glynhudson/emonTX-SMT/Datasheets/IC's/WiznetW5200820io-Pin.jpg

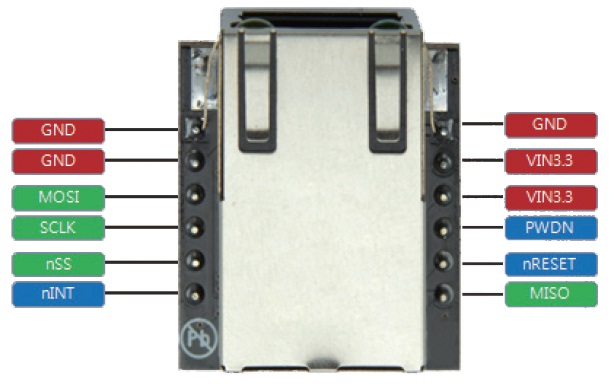
Datasheets/IC's/WiznetW5200820io-Pin.jpg
