glynhudson/emonTX-SMT/README.md

emonTX-SMT
==========

Very early prototype 

openenergymonitor.org

http://openenergymonitor.blogspot.co.uk/search/label/emonTxSMT
http://openenergymonitor.org/emon/node/736
