glynhudson/emonTX-SMT/Datasheets/Atmel AppNote/AppNote Schematic.png

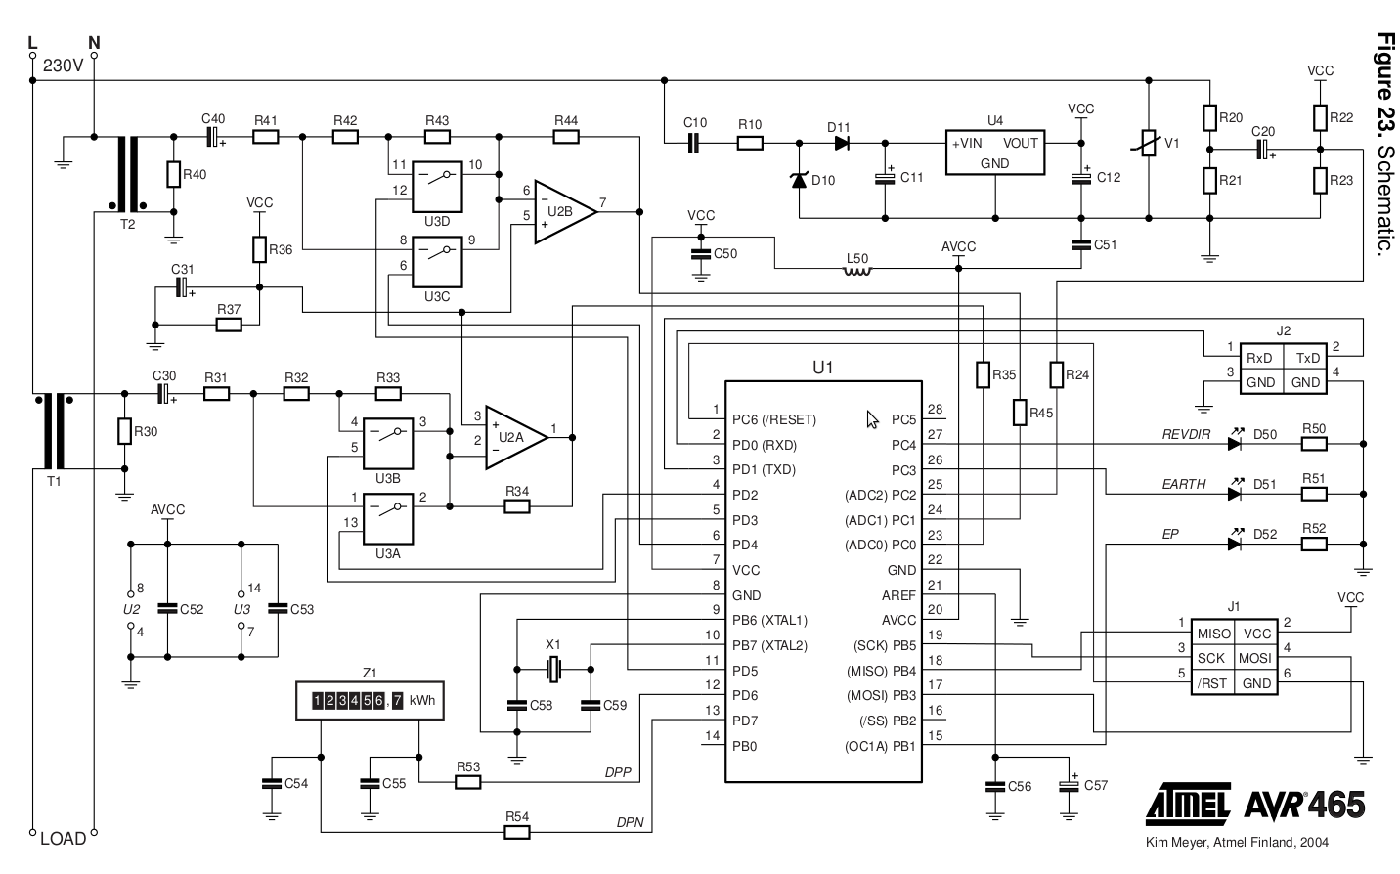
Datasheets/Atmel AppNote/AppNote Schematic.png
