glynhudson/emonTX-SMT/emonTx SMT BOM.ods

Sheet: emonTx SMT BOM
Quantity | Component V0.6 Rev2 | Description | Value | Package | Manufacturer | Manufacturer part No. | RoS | Farnel Code | Farnel Price 100 off | Farnell 100 off board price | RS Code | Rapid Code | Cheapest | Exact Value critical | Country of Origin | Notes
Passives
3 |  | Resistor – CT Burden | 18R 0.25W 1% | 1206 |  |  | YES | 1100145 | £0.01 | £0.04 | 223-2029 | 72-2224 | Rapid
1 |  | Resistor – one-wire temperature | 4.7K | 1206 |  |  | YES | 1470013 (http://uk.farnell.com/vishay-draloric/crcw12064k70fkea/resistor-1206-4k70-1/dp/1470013) | £0.02 | £0.02
4 |  | Resistor – indicator LED's current limiting resistor
1 | R39 | Resistor – AC-DC current limiting | 56R 0.75W 1% (must be 0.62W min) | 2010 | Multicomp | MCPWR10FTEQ0560 | YES | 1887586 (http://uk.farnell.com/multicomp/mcpwr10fteq0560/resistor-2010-56r-1-0-75w/dp/1887586) | £0.08 | £0.08 | nope |  |  | YES! | Taiwan
2 |  | Capacitor – Ceramic - crystal de-coupling | 22pF | 0630 |  |  | YES | 1759057 | £0.01 | £0.01 | 616-9133 | 71-1792
8 |  | Capacitor – de-coupling | 0.1uF | 0603 |  |  | YES | 1759066 | £0.01 | £0.05 | 723-5521 | 71-1854
1 |  | Capacitor – ceramic – v reg output, AC sample – DC supply de-coupling | 1uf 25V | 0603 |  |  | YES | 1759039 | £0.01 | £0.01 | 723-5587 | N/A
2 |  | Capacitor | 10uF 16V | B (4mm) |  |  | YES | 9696920 | £0.08 | £0.17 | 737-9625 | 131794
5 | (C1, C18), C13, C15, C20 | Capacitor – AC to DC rectifier smoothing & CT input de-coupling | 47uF 25V | D (6.3mm) |  |  | YES | 1870614 (http://uk.farnell.com/multicomp/mcesl25v476m6-3x5-4/capacitor-47uf-25v-6-3mm-x-5-4mm/dp/1870614) | £0.11 | £0.55 |  |  |  | only C1 and C18 need to be 25V | China
3 |  | Inductor | 3A 30ohm | 0603 |  |  |  | 1308763 | £0.13 | £0.40
 |  |  |  |  |  |  | YES |  |  | £0.00
Discrete's |  |  |  |  |  |  |  |  |  | #VALUE!
1 | D2 | Reverse blocking power supply diode – Schottky | B052 (62mW Av min) | SOD-123 | Taiwan Semiconductor | B0520LW | YES | 1863141 (http://uk.farnell.com/taiwan-semiconductor/b0520lw/diode-rectif-20v-0-5a-sod123/dp/1863141) | £0.05 | £0.05 | 743-5894 (http://uk.rs-online.com/web/p/rectifier/7435894/) |  | About the same, 50 MOQ RS | No
1 | D1 | Rectifier Diode – AC-DC supply | 1N4148 30V 150mA Av min | SOD-323 |  |  | YES | 1612348 | £0.05 | £0.05 |  |  |  |  | China
1 | U$11 | 12V zener diode – MCp1702 protection from AC over voltage | 12V Zener | SOD-323 |  |  | YES | 1466027 (http://uk.farnell.com/multicomp/bzt52c12s/diode-zener-0-2w-sod-323/dp/1466027) | £0.08 | £0.08 |  |  |  |  | India
1 |  | SMT LED's |  | 0603 |  |  |  |  | £0.08 | £0.08 |  | 56-3102 (http://www.rapidonline.com/Electronic-Components/0603-1-8v-Red-LED-Surface-Mount-40mcd-56-3102)
1 | L1 | AREF filter FERRITE BEAD | 30 ohm 3A | 0603 |  |  |  | 1308763 | £0.11 | £0.11
1 |  | 16Mhz Crystal | 16Mhz | HC49/US |  |  | YES | 1469641 | £0.21 | £0.21 | 703-7129P | 90-1932 | Farnell |  | Mexico
 |  |  |  |  |  |  |  |  |  | £0.00
IC's |  |  |  |  |  |  |  |  |  | #VALUE!
1 |  | 3.3V LOD voltage regulator | MCP1702 3.3V | SOT-89 | Microchip | MCP1702T-3302E/MB | YES | 1605558 | £0.25 | £0.25 | 669-4872 (http://uk.rs-online.com/web/p/low-dropout-voltage-regulators/6694872/) |  | RS | Yes | US
1 |  | 433/868/912Mhz RF transceiver | RFM12B |  | HopeRF/RF Solutions |  |  |  |  | £0.00
1 |  | 8-bit micro controller | Atmega32u4 | TQFP44 | ATMEL | ATMEGA32U4-AU | YES | 1748525MPKG | £3.63 | £3.63 |  |  | RS |  | US
1 |  | Low power Quad Op Amp | LMV324 | SOIC14 | Texas Instruments / STMICROELECTRONICS | LMV324ID | YES | 1102986 | £0.37 | £0.37 | 517-1517 |  | RS
2 |  | Quad Bilateral Analogue Switch | 4066 | SOIC14 | NXP | 4HC4066D | YES | 1201330 | £0.36 | £0.72 | 169-7790 |  | RS – a lot less!
port |  |  |  |  |  |  |  |  |  | #VALUE!
Connectors |  |  |  |  |  |  |  |  |  | #VALUE!
1 |  | USB MicroB |  | SMT | Molex | 47346-0001 | YES | 1568026 | £0.40 | £0.40 | 702-5475P |  | Farnel | YES! | China | Must not have any thru-hole, SMT pads only
3 |  | 3.5mm jack through-hole | Stereo 3.5mm jack | Thru-hole | TruConnect |  | YES |  | £0.17 | £0.52 | 20-0157 |  | Rapid
1 |  | Terminal block 12 – pluggable |  |  | RIA Connect |  |  |  | £2.46 | £2.46 | 493-2563 | 21-4224 (http://www.rapidonline.com/Cables-Connectors/12-Pole-2-5mm-Pitch-Springcon-Lever-Female-Plug-21-4224) | RAPID
1 |  | Terminal block 12 male thu hole right angle |  |  | RIA connect |  |  |  | £0.71 | £0.71 |  | 21-4240 (http://www.rapidonline.com/Cables-Connectors/12-Pole-2-5mm-Pitch-PCB-Mount-Right-Angle-Male-Socket-21-4240) | RAPID
1 |  | 2.1mm Barrel Jack – AC voltage | 2.1mm SMT | SMT | Cliff | FC68148S |  | 1889309 |  | £0.00 |  | 20-0896 | Farnell
1 |  | SMA Ant PCB 90 degrees |  | Tru-hole | TruConnect | 19-49-1-TGG | YES | 2079861 | £0.74 | £1.70 | 512-0070 | 16-1562 | Rapid – by far
2 |  | Xbee Headers | 10pin, 1 row, 2mm pitch | Thru-hole |  |  | YES | 1109732 |  | £0.00 | 605-8796 |  | RS
 |  |  |  |  |  |  |  |  |  | £0.00
 |  |  |  |  |  |  |  |  |  | £0.00
Misc |  |  |  |  |  |  |  |  |  | #VALUE!
1 |  | 3x AAA PCB battery holder | 4.5V | PCB mount | TruPower | BH-331P | YES | 1339843 |  | £0.25 | 481-4077 | 18-2967 | Rapid – by far
1 |  | 433Mhz Ant straight | 433Mhz | SMA | RF-solutions |  | YES | 1304036 |  | £4.91 | 542-535 |  | RS |  |  | 90 degree is actually cheaper on RS
1 |  | 434Mhz Ant 90 degrees | 434Mhz | SMA | RF-solutions |  | YES |  |  | £3.25 | 542-488 |  | RS
1 |  | 868Mhz Ant straight | 868Mhz | SMA | RF-solutions |  | YES | 1304037 |  | £4.91 | 542-551 |  | Rs
1 |  | 868Mhz Ant 90 degrees | 869Mhz | SMA | RF-solutions |  | YES | 1717225RL (http://uk.farnell.com/bourns/mf-fsmf020x-2/multifuse-smd-0603-0-2a/dp/1717225RL) |  | £2.14 | 542-563 |  | RS
1 |  | USB PTC Fuse | 200mA holding 500mA trip? | ??? |  |  | YES |  |  | £0.00
1 | R23 | AC-DC PTC Fuse | 40mA holding 150mA trip | 1210 |  |  |  | 1861176 (http://uk.farnell.com/multicomp/mc36203/resettable-fuse-smd-0-05a/dp/1861176) | £0.09 | £0.09 |  |  |  |  | Taiwan

Sheet: Op-amp Test
1 | C31 | Bias stabilising cap | 10 uF | 3201454
5 | C20, C30, C40 | DC decoupling caps on input stage | 47 uF | 3201478
1 | R20, | Top AC adapter step down (best precision?) | 10 k
4 | R21, R24, R35, R45 | Bottom step down (best precision?) and current limiting resistors | 1 kΩ | 332690
4 | R22, R36, R23, R37 | Biasing voltage dividers (best precision?) | 1 M (or 470k probably fine for testing)
4 | R30, R40 | Burden resistor (best precision?) | 18 Ohms
4 | R31, R41 | Opamp gain resistors (best precision?) | 6.8 kΩ | 332793
4 | R32, R42 | Opamp gain resistors (best precision?) | 39 kΩ | 332884
4 | R33, R43 | Opamp gain resistors (best precision?) | 330 kΩ | 332999
4 | R34, R44 | Opamp gain resistors (best precision?) | 470 kΩ | 333013
1 | U2 | Quad, Low-Voltage, Rail-to-Rail Op Amp | LMV324
1 | U2 | Dual version incase quad has problems | LMV358 | 3555768
2 | U3 | Quad Bilateral Switch | CD4066BCN | 380957
Is there any benefit in using this regulator?
 | U4 | Linear Regulator, 3.3V | LM1117MP-3.3 | 120765
