glynhudson/emonTX-SMT/Datasheets/Atmel AppNote/App note BOM.png

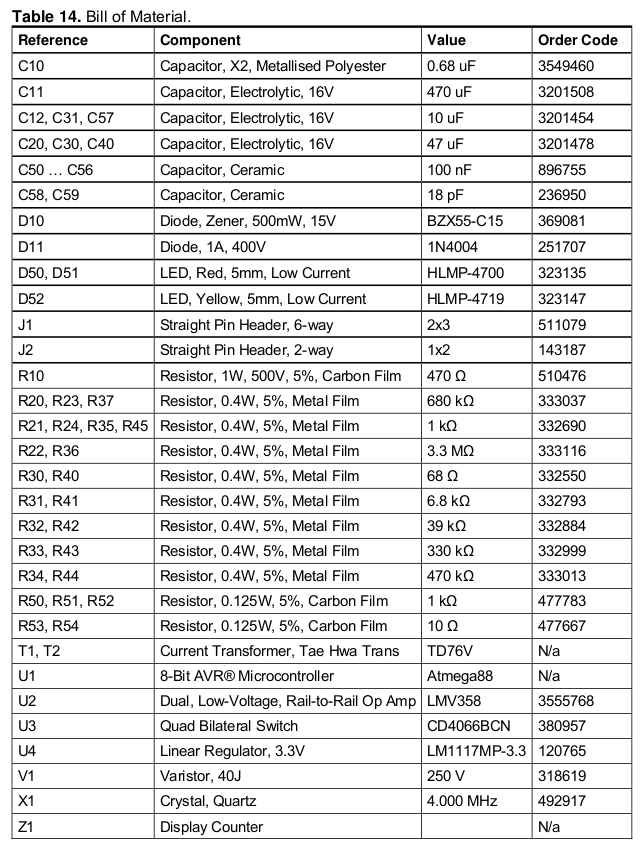
Datasheets/Atmel AppNote/App note BOM.png
