glynhudson/emonTX-SMT/Schematic/emonTx SMT07.brd

## EAGLE design Schematic/emonTx SMT07.brd (2012-10-09)

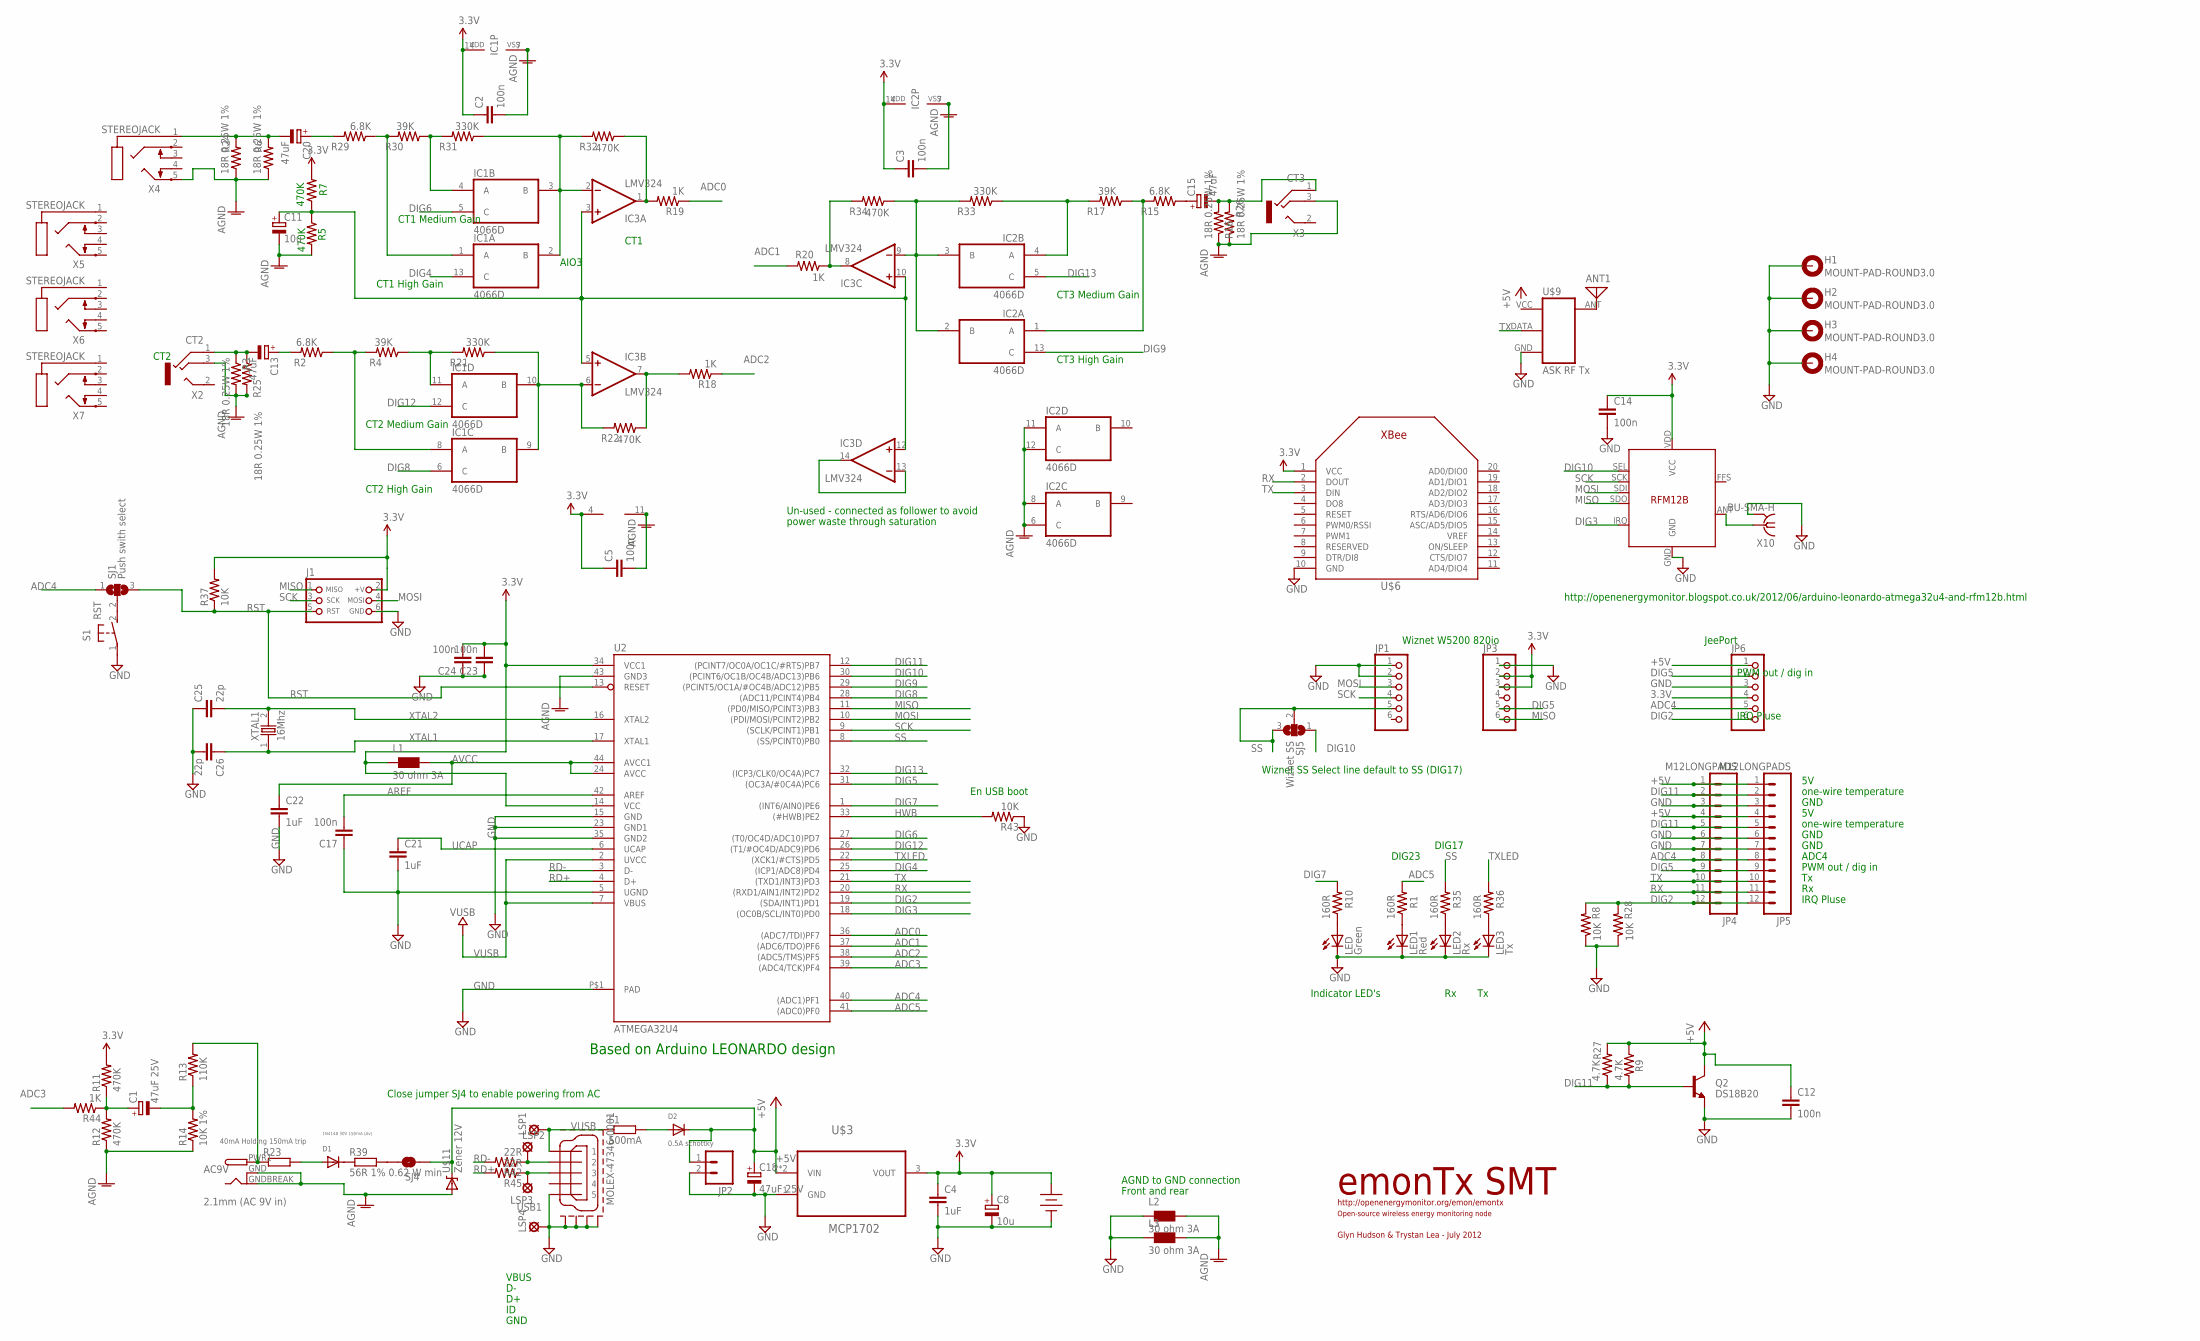
[picture p4: schematic emonTx SMT07.sch]

Parts:
3XAAA: 4.5V; AAA_PCB_HOLDER
AC9V: 2.1mm (AC 9V in); DCJACK_2MM_SMT
ANT1: ANTENNA; PAD-01
C1, C18: 47uF 25V; PANASONIC_D
C2, C3, C5, C12, C14, C17, C23, C24: 100n; 0603-CAP
C4: 1uF; C0603
C8, C11: 10u; PANASONIC_B
C13, C15, C20: 47uF; PANASONIC_D
C21: 1uF; 0603-CAP
C22: 1uF; C0603-ROUND
C25, C26: 22p; 0603-CAP
D1: 1N4148 30V 150mA (Av); SOD-323F
D2: 0.5A schottky; SOD-123
F1: 500mA; R1210
H1, H2, H3, H4: MOUNT-PAD-ROUND3.0; 3,0-PAD
IC1, IC2: 4066D; SO14
IC3: LMV324; SO14
J1: CON_HEADER_PRG_AVR_ICSP; HEADER_PRG_2X03
JP1, JP3, JP6: PINHD-1X6; 1X06
JP2: M02LOCK_LONGPADS; 1X02_LOCK_LONGPADS
JP4, JP5: M12LONGPADS; 1X12_LONGPADS
L1, L2, L3: 30 ohm 3A; 0603
LED: Green; CHIPLED_0603
LED1: Red; CHIPLED_0603
LED2: Rx; CHIPLED_0603
LED3: Tx; CHIPLED_0603
LSP1, LSP2, LSP3, LSP4: LSP11
Q2: DS18B20; TO-92
R1, R10, R35, R36: 160R; 0603-RES
R2, R15, R29: 6.8K; 0603-RES
R3, R6, R16: 18R 0.25W 1%; 1206
R4, R17, R30: 39K; 0603-RES
R5, R7, R11, R12, R22, R32, R34: 470K; 0603-RES
R8, R37, R43: 10K; 0603-RES
R9: 4.7K; 1206
R13: 110K; 0603-RES
R14: 10K 1%; 0603-RES
R18, R19, R20, R44: 1K; 0603-RES
R21, R31, R33: 330K; 0603-RES
R23: 40mA Holding 150mA trip; R1210
R24, R25, R26: 18R 0.25W 1%; AXIAL-0.4
R27: 4.7K; AXIAL-0.4
R28: 10K; AXIAL-0.4
R39: 56R 1% 0.62 W min; RESISTOR_R2010
R42, R45: 22R; 0603-RES
S1: RST; B3F-31XX
SJ1: Push swith select; SJ_2W
SJ4: SOLDERJUMPER-OLDNO; SJ_2S-NO
SJ5: Wiznet SS; SJ_2W
U2: ATMEGA32U4; TQFP44-PAD
U$1: RFM12B
U$3: MCP1702; SOT89
U$6: XBEE
U$9: ASK RF Tx; RF-LINK_TX
U$11: Zener 12V; SOD-323
USB1: MOLEX-47346-0001; MOLEX-47364-0001
X2: CT2; 1503_02
X3: CT3; 1503_02
X4, X5, X6, X7: STEREOJACK; STX3100
X10: BU-SMA-H
XTAL1: 16Mhz; HC-49U

Connections:
3.3V: 3XAAA.+, C2.1, C3.1, C4.1, C5.1, C8.+, C14.1, C23.2, C24.2, IC1.14 (VDD), IC2.14 (VDD), IC3.4 (V+), J1.2 (+V), JP3.2, JP3.3, JP6.4, L1.1, R7.2, R11.2, R37.2, U2.14 (VCC), U2.34 (VCC1), U$1.VDD (VCC), U$3.3 (VOUT), U$6.1 (VCC)
+5V: C12.1, C18.+, D2.C, JP2.1, JP4.1, JP4.4, JP5.1, JP5.4, JP6.1, Q2.3 (C), R9.1, R27.P$2 (2), SJ4.1, U$3.2 (VIN), U$3.2.1 (VIN), U$9.VCC (+5V), U$11.1 (C)
ADC0: R19.1, U2.36 ((ADC7/TDI)PF7)
ADC1: R20.2, U2.37 ((ADC6/TDO)PF6)
ADC2: R18.1, U2.38 ((ADC5/TMS)PF5)
ADC3: R44.2, U2.39 ((ADC4/TCK)PF4)
ADC4: JP4.8, JP5.8, JP6.5, SJ1.1, U2.40 ((ADC1)PF1)
ADC5: R1.2, U2.41 ((ADC0)PF0)
AGND: AC9V.GND (GNDBREAK), AC9V.GNDBREAK (GND), C2.2, C3.2, C5.2, C11.-, IC1.7 (VSS), IC2.6 (C), IC2.7 (VSS), IC2.8 (A), IC2.11 (A), IC2.12 (C), IC3.11 (V-), L2.2, L3.2, R3.2, R5.2, R6.1, R12.1, R14.1, R16.1, R24.P$1 (1), R25.P$2 (2), R26.P$1 (1), U2.43 (GND3), U$11.2 (A), X2.3, X3.3, X4.5
AREF: C17.2, U2.42 (AREF)
AVCC: C22.1, L1.2, U2.24 (AVCC), U2.44 (AVCC1)
DIG2: JP4.12, JP5.12, JP6.6, R8.2, R28.P$2 (2), U2.19 ((SDA/INT1)PD1)
DIG3: U2.18 ((OC0B/SCL/INT0)PD0), U$1.IRQ
DIG4: IC1.13 (C), U2.25 ((ICP1/ADC8)PD4)
DIG5: JP3.5, JP4.9, JP5.9, JP6.2, U2.31 ((OC3A/#0C4A)PC6)
DIG6: IC1.5 (C), U2.27 ((T0/OC4D/ADC10)PD7)
DIG7: R10.2, U2.1 ((INT6/AIN0)PE6)
DIG8: IC1.6 (C), U2.28 ((ADC11/PCINT4)PB4)
DIG9: IC2.13 (C), U2.29 ((PCINT5/OC1A/#OC4B/ADC12)PB5)
DIG10: SJ5.1, U2.30 ((PCINT6/OC1B/OC4B/ADC13)PB6), U$1.SEL
DIG11: JP4.2, JP4.5, JP5.2, JP5.5, Q2.2 (B), R9.2, R27.P$1 (1), U2.12 ((PCINT7/OC0A/OC1C/#RTS)PB7)
DIG12: IC1.12 (C), U2.26 ((T1/#OC4D/ADC9)PD6)
DIG13: IC2.5 (C), U2.32 ((ICP3/CLK0/OC4A)PC7)
GND: 3XAAA.-, C4.2, C8.-, C12.2, C14.2, C17.1, C18.-, C21.2, C22.2, C23.1, C24.1, C25.1, C26.2, H1.B3,0, H2.B3,0, H3.B3,0, H4.B3,0, J1.6 (GND), JP1.1, JP1.2, JP2.2, JP3.1, JP4.3, JP4.6, JP4.7, JP5.3, JP5.6, JP5.7, JP6.3, L2.1, L3.1, LED.C, LED1.C, LED2.C, LED3.C, LSP4.MP, Q2.1 (E), R8.1, R28.P$1 (1), R43.1, S1.1, U2.5 (UGND), U2.15 (GND), U2.23 (GND1), U2.35 (GND2), U2.P$1 (PAD), U$1.GND, U$3.1 (GND), U$6.10 (GND), U$9.GND, USB1.5, USB1.GND1, USB1.GND2, USB1.GND3, USB1.GND4, X10.2 (GND), X10.3 (GND), X10.4 (GND), X10.5 (GND)
HWB: R43.2, U2.33 ((#HWB)PE2)
MISO: J1.1 (MISO), JP3.6, U2.11 ((PD0/MISO/PCINT3)PB3), U$1.SDO
MOSI: J1.4 (MOSI), JP1.3, U2.10 ((PDI/MOSI/PCINT2)PB2), U$1.SDI
unnamed: S1.2 (S), SJ1.2
unnamed: LED.A, R10.1
unnamed: AC9V.PWR1 (PWR), R13.2, R23.1
unnamed: D2.A, F1.2
unnamed: C1.-, R13.1, R14.2
unnamed: D1.C, R39.1
unnamed: C20.+, R29.2
unnamed: LED1.A, R1.1
unnamed: C1.+, R11.1, R12.2, R44.1
unnamed: R39.2, SJ4.2
unnamed: ANT1.1, U$9.ANT
unnamed: LSP2.MP, R42.1, USB1.2
unnamed: U$1.ANT, X10.1
unnamed: C15.-, R16.2, R26.P$2 (2), X3.1
unnamed: LSP3.MP, R45.1, USB1.3
unnamed: IC1.4 (A), R30.1, R31.2
unnamed: IC1.1 (A), R29.1, R30.2
unnamed: C13.+, R2.2
unnamed: LED2.A, R35.1
unnamed: C13.-, R3.1, R25.P$1 (1), X2.1
unnamed: C20.-, R6.2, R24.P$2 (2), X4.1
unnamed: C11.+, IC3.3 (+IN), IC3.5 (+IN), IC3.10 (+IN), IC3.12 (+IN), R5.1, R7.1
unnamed: C15.+, R15.1
unnamed: IC1.8 (A), R2.1, R4.2
unnamed: IC1.11 (A), R4.1, R21.2
unnamed: IC3.7 (OUT), R18.2, R22.1
unnamed: IC1.9 (B), IC1.10 (B), IC3.6 (-IN), R21.1, R22.2
unnamed: IC1.2 (B), IC1.3 (B), IC3.2 (-IN), R31.1, R32.2
unnamed: IC3.1 (OUT), R19.2, R32.1
unnamed: LED3.A, R36.1
unnamed: IC2.2 (B), IC2.3 (B), IC3.9 (-IN), R33.2, R34.1
unnamed: IC3.13 (-IN), IC3.14 (OUT)
unnamed: IC3.8 (OUT), R20.1, R34.2
unnamed: IC2.1 (A), R15.2, R17.1
unnamed: IC2.4 (A), R17.2, R33.1
unnamed: D1.A, R23.2
RD+: R45.2, U2.4 (D+)
RD-: R42.2, U2.3 (D-)
RST: J1.5 (RST), R37.1, SJ1.3, U2.13 (RESET)
RX: JP4.11, JP5.11, U2.20 ((RXD1/AIN1/INT2)PD2), U$6.2 (DOUT)
SCK: J1.3 (SCK), JP1.4, U2.9 ((SCLK/PCINT1)PB1), U$1.SCK
SS: JP1.5, R35.2, SJ5.2, SJ5.3, U2.8 ((SS/PCINT0)PB0)
TX: JP4.10, JP5.10, U2.21 ((TXD1/INT3)PD3), U$6.3 (DIN), U$9.DATA
TXLED: R36.2, U2.22 ((XCK1/#CTS)PD5)
UCAP: C21.1, U2.6 (UCAP)
VUSB: F1.1, LSP1.MP, U2.2 (UVCC), U2.7 (VBUS), USB1.1
XTAL1: C26.1, U2.17 (XTAL1), XTAL1.1
XTAL2: C25.2, U2.16 (XTAL2), XTAL1.2

Notes on the sheet:
CT2
CT1
http://openenergymonitor.org/emon/emontx
Open-source wireless energy monitoring node
emonTx SMT
Glyn Hudson & Trystan Lea - July 2012
AIO3
Based on Arduino LEONARDO design
Wiznet W5200 820io
Close jumper SJ4 to enable powering from AC
En USB boot
Wiznet SS Select line default to SS (DIG17)
CT1 High Gain
CT1 Medium Gain
DIG23
http://openenergymonitor.blogspot.co.uk/2012/06/arduino-leonardo-atmega32u4-and-rfm12b.html
CT2 Medium Gain
CT2 High Gain
CT3 Medium Gain
CT3 High Gain
PWM out / dig in
IRQ Pluse
AGND to GND connection
Front and rear
ADC4
one-wire temperature
GND
VBUS
Indicator LED's
Rx Tx
Un-used - connected as follower to avoid
power waste through saturation
DIG17
JeePort

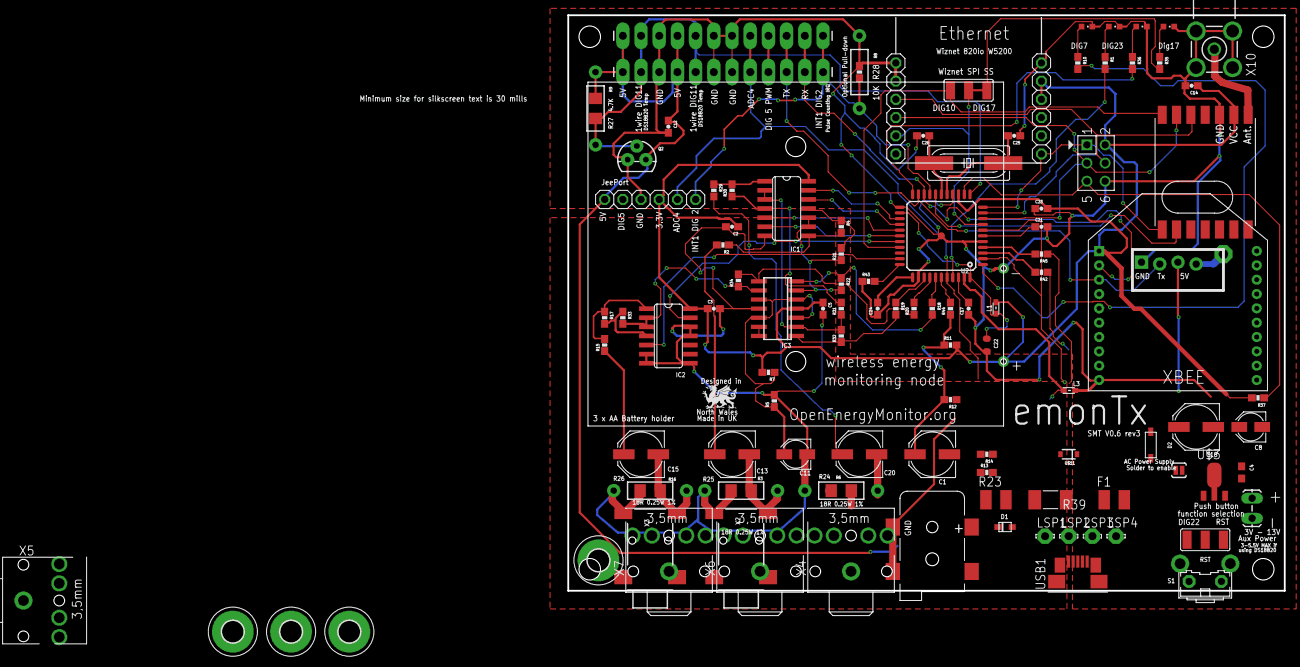
[picture p5: board emonTx SMT07.brd from above]

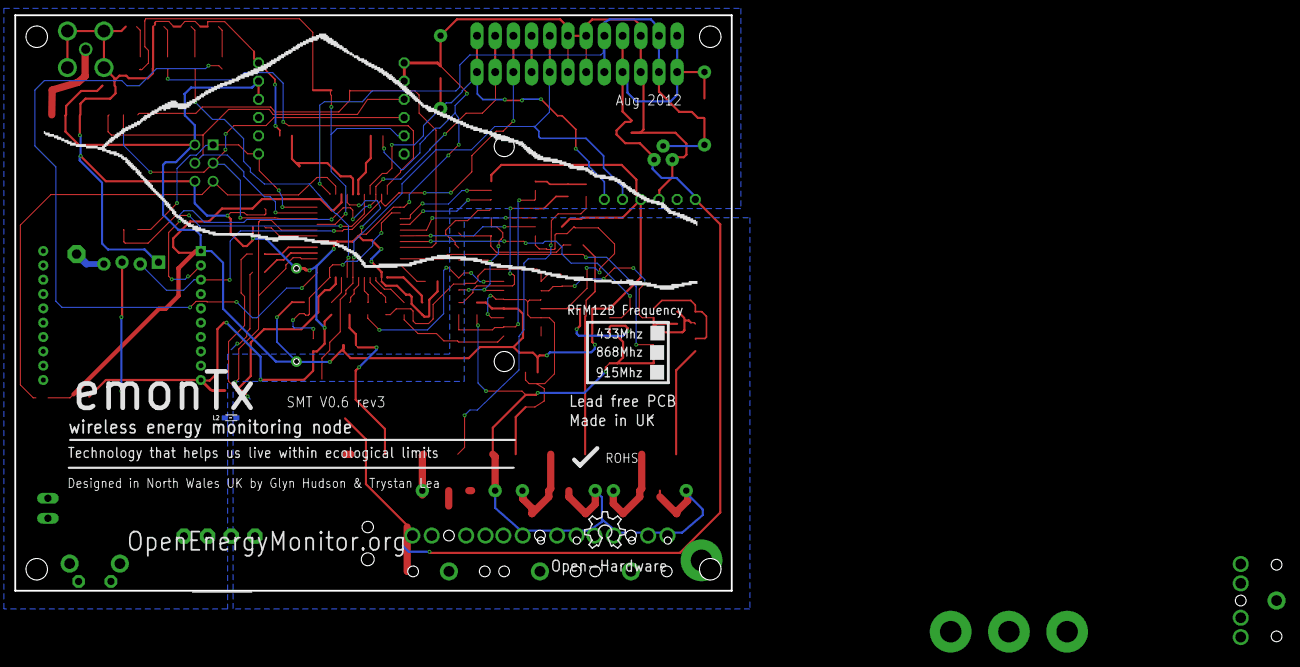
[picture p6: board emonTx SMT07.brd from below]

Board: 2 copper layers, 100.0 x 80.3 mm, 115 parts (3 on the bottom side), 75 nets.

Other parts of the board:
U$2: Open-source Hardware; OSHW_8X200_NOTEXT
U$5: CNICHT
