glynhudson/emonTX-SMT/Firmware/Testing/Multi_gain_opamp_tester/Multi_gain_opamp_tester.ino

/*
  Blink
  Turns on an LED on for one second, then off for one second, repeatedly.
 
  This example code is in the public domain.
 */
 
// Pin 13 has an LED connected on most Arduino boards.
// give it a name:
const int led = 7;
const int medium=13;
const int high=9;
const int adc=1;

// the setup routine runs once when you press reset:
void setup() {                
  // initialize the digital pin as an output.
  pinMode(led, OUTPUT);  
  pinMode(medium, OUTPUT); 
  pinMode(high, OUTPUT);  
  Serial.begin(9600);
}

// the loop routine runs over and over again forever:
void loop() {
  digitalWrite(led, HIGH);   // turn the LED on (HIGH is the voltage level)
  delay(500);               // wait for a second
  digitalWrite(medium, LOW);
  digitalWrite(high, LOW);
  delay(1000);
  Serial.println(analogRead(adc));
  digitalWrite(medium, HIGH);
  delay(1000);
  Serial.println(analogRead(adc));
  digitalWrite(high, HIGH);
  delay(1000);
  Serial.println(analogRead(adc));
   Serial.println("   ");
  digitalWrite(led, LOW);    // turn the LED off by making the voltage LOW
  delay(500);               // wait for a second
}
