glynhudson/emonTX-SMT/(commit log)

2012-09-17 first commit at V0.6.5
    [emonTx SMT BOM.ods, emonTx SMT Portmap.ods, emonTx SMT07.brd, emonTx SMT07.sch]
2012-09-17 route uvcc to connect to USB 5V
    [emonTx SMT07.brd]
2012-09-21 update schotkey reverse blocking diode pcb footprint to SOD-123
    [emonTx SMT BOM.ods, emonTx SMT07.brd, emonTx SMT07.sch]
2012-10-02 added testing firmware examples
    [emonTx SMT BOM.ods]
2012-10-05 add tru-hole 3.5mm to BOM
    [emonTx SMT BOM.ods]
2012-10-09 connect wiznet reset to dig5, need to route
    [emonTx SMT BOM.ods, emonTx SMT Portmap.ods, emonTx SMT07.brd, emonTx SMT07.sch]
